NSDN/NGP/emulator/README.txt

看样子你需要去单独下载SDL2的lib，并放置到SDL2\lib\[x64/x86]下面
地址->https://www.libsdl.org/release/SDL2-devel-2.0.5-VC.zip
下载后解压并将SDL2-2.0.5文件夹内所有文件复制到项目文件夹下的SDL2里面，新版本的SDL2类推。
