NSDN/NGP/old-8bit/Cover.docx

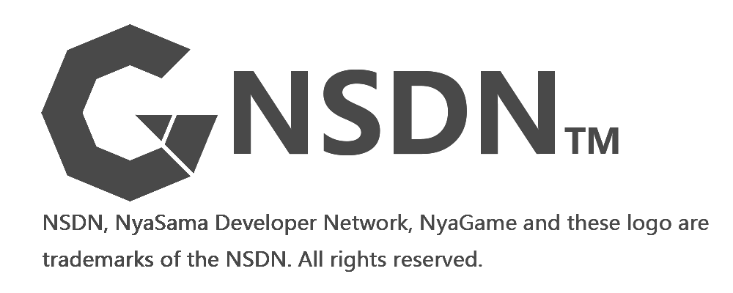
[picture p1: figure]
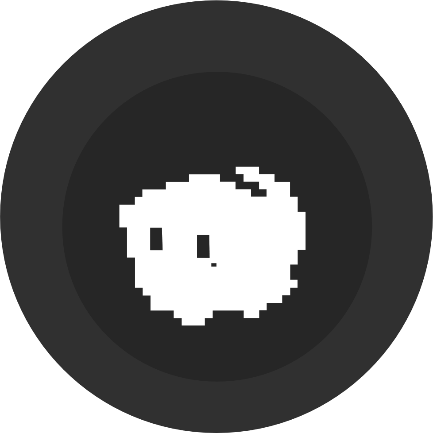
[picture p2: figure]

nyagame portable 8-bit

development doc
