NSDN/NGP/(list of files, drawings)

Other design files:
boards/ngp-main/logo.PcbLib
boards/ngp-main/ngp-main.PrjPCB
boards/ngp-main/ngp-main.SchDoc
boards/ngp-main/st-link.SchDoc
boards/st-link/st-link.PrjPCB
boards/st-link/st-link.SchDoc
layout/NyaGamePortable-32Bit-v1.0.lay6
layout/NyaGamePortable-32Bit-v1.1.lay6
layout/NyaGamePortable-32Bit-v1.2.lay6
old-8bit/Layout/NyaGamePortable-8Bit-v1.1.lay6
old-8bit/Layout/NyaGamePortable-8Bit-v1.2.lay6
old-8bit/Layout/NyaGamePortable-8Bit-v1.05.lay6
old-8bit/Layout/NyaGamePortable-8Bit.lay6
