NSDN/NGP/firmware/ngp-core/Src/main.c

/**
  ******************************************************************************
  * @file           : main.c
  * @brief          : Main program body
  ******************************************************************************
  * This notice applies to any and all portions of this file
  * that are not between comment pairs USER CODE BEGIN and
  * USER CODE END. Other portions of this file, whether 
  * inserted by the user or by software development tools
  * are owned by their respective copyright owners.
  *
  * Copyright (c) 2018 STMicroelectronics International N.V. 
  * All rights reserved.
  *
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
  ******************************************************************************
  */
/* Includes ------------------------------------------------------------------*/
#include "main.h"
#include "stm32f4xx_hal.h"
#include "fatfs.h"
#include "usb_device.h"

/* USER CODE BEGIN Includes */
#include "usbd_core.h"

#include "irq.h"
#include "lcd.h"
#include "rgboled.h"
#include "keypad.h"
#include "beeper.h"
#include "flash.h"

#define VERSION "dev180521"
/* USER CODE END Includes */

SD_HandleTypeDef hsd;

SPI_HandleTypeDef hspi1;

TIM_HandleTypeDef htim10;

UART_HandleTypeDef huart1;
UART_HandleTypeDef huart2;

/* USER CODE BEGIN PV */
	LCD* dev;
	Flash* flash;
	static uint8_t sdOK = 0;
	static uint8_t menu = 0;
	static uint8_t music = 0;
	
	const uint8_t cmusic = 7;
	
	HAL_SD_CardInfoTypeDef SDCardInfo;

	FATFS fileSystem;
	FIL testFile;
	uint8_t testBuffer[16] = "Hello Gensokyo!\0";
	UINT testBytes;
	FRESULT res;
/* USER CODE END PV */

void SystemClock_Config(void);
static void MX_GPIO_Init(void);
static void MX_SDIO_SD_Init(void);
static void MX_SPI1_Init(void);
static void MX_TIM10_Init(void);
static void MX_USART1_UART_Init(void);
static void MX_USART2_UART_Init(void);

/* USER CODE BEGIN PFP */

/** STG Begin *********************************************************************/

#define STG_BACK 1
#define STG_MAIN 2
#define STG_COLORB 0x000000

#define RANGE_X1 4
#define RANGE_Y1 4
#define RANGE_X2 92
#define RANGE_Y2 123

void onInitPlayer(void);
void onUpdatePlayer(void);
struct Player {
	uint32_t color;
	uint8_t size;
	double x;
	double y;
	double prevX;
	double prevY; 
	void (*onInit)();
	void (*onUpdate)();
} player = { 0xFF9800, 1,
	(RANGE_X2 + RANGE_X1) / 2, 108,
	(RANGE_X2 + RANGE_X1) / 2, 108,
	&onInitPlayer,
	&onUpdatePlayer
};
void onInitPlayer() {
	player.x = (RANGE_X2 + RANGE_X1) / 2;
	player.y = 108;
}
void onUpdatePlayer() {
	player.prevX = player.x; player.prevY = player.y;
	if (checkKey(LPAD_LEFT)) { player.x -= 0.4; }
	if (checkKey(LPAD_RIGHT)) { player.x += 0.4; }
	if (checkKey(LPAD_UP)) { player.y -= 0.4; }
	if (checkKey(LPAD_DOWN)) { player.y += 0.4; }

	if (player.x > RANGE_X2 - player.size) player.x = RANGE_X2 - player.size;
	if (player.x < RANGE_X1 + player.size) player.x = RANGE_X1 + player.size;
	if (player.y > RANGE_Y2 - player.size) player.y = RANGE_Y2 - player.size;
	if (player.y < RANGE_Y1 + player.size) player.y = RANGE_Y1 + player.size;

	if ((char) player.x != (char) player.prevX || (char) player.y != (char) player.prevY) {
		dev->colorf(dev->p, STG_COLORB);
		dev->rect(dev->p,
			player.prevX - player.size, player.prevY - player.size,
			player.prevX + player.size, player.prevY + player.size,
			1
		);
	}
	dev->colorf(dev->p, player.color);
	dev->rect(dev->p,
		player.x - player.size, player.y - player.size,
		player.x + player.size, player.y + player.size,
		1
	);
}

void STG(uint8_t type) {
	if (type == STG_BACK) {
		dev->colorf(dev->p, 0xFFFFFF);
		dev->rect(dev->p, RANGE_X1 - 4, RANGE_Y1 - 4, RANGE_X2 + 4, RANGE_Y2 + 4, 1);
		dev->colorf(dev->p, STG_COLORB);
		dev->rect(dev->p, RANGE_X1 - 2, RANGE_Y1 - 2, RANGE_X2 + 2, RANGE_Y2 + 2, 1);
		dev->colorf(dev->p, 0xFFFFFF);
		dev->rect(dev->p, RANGE_X1 - 1, RANGE_Y1 - 1, RANGE_X2 + 1, RANGE_Y2 + 1, 0);
		dev->colorf(dev->p, 0x7986CB);
		dev->font(dev->p, Big);
		dev->draw(dev->p, RANGE_X2 + 12, RANGE_Y1 + 4, 'T');
		dev->draw(dev->p, RANGE_X2 + 12 + 8, RANGE_Y1 + 4, 'H');
		dev->font(dev->p, Small);
		dev->colorf(dev->p, 0xFFFFFF);
		
		player.onInit();
	} else if (type == STG_MAIN) {
		player.onUpdate();
	}
}

/** STG End ***********************************************************************/

/* USER CODE END PFP */

/* USER CODE BEGIN 0 */
void checkSD() {
	if (HAL_GPIO_ReadPin(SDST_GPIO_Port, SDST_Pin) == GPIO_PIN_RESET && sdOK == 0) {
		HAL_SD_Init(&hsd);
		HAL_SD_GetCardInfo(&hsd, &SDCardInfo);
		sdOK = 1;
		USBD_Start(&hUsbDeviceFS);
	} else if (HAL_GPIO_ReadPin(SDST_GPIO_Port, SDST_Pin) == GPIO_PIN_SET && sdOK == 1) {
		HAL_SD_DeInit(&hsd);
		sdOK = 0;
		USBD_Stop(&hUsbDeviceFS);
	}
	if (sdOK == 1) {
		dev->colorb(dev->p, 0x66CCFF);
		dev->colorf(dev->p, 0x000000);
		dev->print(dev->p, 113, 118, "SD");
		dev->colorf(dev->p, 0x66CCFF);
		dev->rect(dev->p, 113, 117, 125, 125, 0);
		dev->colorb(dev->p, 0x000000);
		dev->colorf(dev->p, 0xFFFFFF);
	} else {
		dev->p->foreColor = dev->p->backColor;
		dev->rect(dev->p, 113, 117, 125, 125, 1);
		dev->colorf(dev->p, 0xFFFFFF);
	}
}

int halfWidth() { return dev->p->width / 2 - 1; }
int halfHeight() { return dev->p->height / 2 - 1; }
/* USER CODE END 0 */

/**
  * @brief  The application entry point.
  *
  * @retval None
  */
int main(void)
{
  /* MCU Configuration----------------------------------------------------------*/

  /* Reset of all peripherals, Initializes the Flash interface and the Systick. */
  HAL_Init();

  /* Configure the system clock */
  SystemClock_Config();

  /* Initialize all configured peripherals */
  MX_GPIO_Init();
  MX_SDIO_SD_Init();
  MX_SPI1_Init();
  MX_TIM10_Init();
  MX_USART1_UART_Init();
  MX_USART2_UART_Init();
  MX_FATFS_Init();
  MX_USB_DEVICE_Init();
  /* USER CODE BEGIN 2 */
	USBD_Stop(&hUsbDeviceFS);
	if (HAL_GPIO_ReadPin(SDST_GPIO_Port, SDST_Pin) == GPIO_PIN_RESET && sdOK == 0) {
		HAL_SD_Init(&hsd);
		HAL_SD_GetCardInfo(&hsd, &SDCardInfo);
		sdOK = 1;
		USBD_Start(&hUsbDeviceFS);
	} else if (HAL_GPIO_ReadPin(SDST_GPIO_Port, SDST_Pin) == GPIO_PIN_SET && sdOK == 1) {
		HAL_SD_DeInit(&hsd);
		sdOK = 0;
		USBD_Stop(&hUsbDeviceFS);
	}
  
	HAL_Delay(500);
	
	const uint8_t* logo = getLogo();
	const uint16_t* symbol = getSymbol();

	flash = FlashInit(&hspi1,
			FLASH_CS_GPIO_Port, FLASH_CS_Pin, W25Q64);
	
	dev = LCDInit(&hspi1, 0,
			LCD_DC_GPIO_Port, LCD_DC_Pin, 
			LCD_CS_GPIO_Port, LCD_CS_Pin,
			LCD_RST_GPIO_Port, LCD_RST_Pin,
			LCD_BK_GPIO_Port, LCD_BK_Pin);

	/*dev = LCDInit(&hspi1, 1,
			LCD_DC_GPIO_Port, LCD_DC_Pin,
			LCD_BK_GPIO_Port, LCD_BK_Pin,
			LCD_RST_GPIO_Port, LCD_RST_Pin,
			LCD_CS_GPIO_Port, LCD_CS_Pin);*/

	/*dev = RGBOLEDInit(&hspi1,
			LCD_DC_GPIO_Port, LCD_DC_Pin,
			LCD_CS_GPIO_Port, LCD_CS_Pin,
			LCD_RST_GPIO_Port, LCD_RST_Pin);*/

	dev->reset(dev->p);
	
	dev->init(dev->p);

	dev->colorb(dev->p, 0xFFFFFF);
	dev->colorf(dev->p, 0x000000);
	dev->clear(dev->p);
	dev->bitmapsc(dev->p, halfWidth() - 1, halfHeight() - 1, 64, 64, logo);
	HAL_Delay(2000);
	dev->colorb(dev->p, 0x000000);
	dev->colorf(dev->p, 0xFFFFFF);
	dev->clear(dev->p);
	
	HAL_GPIO_WritePin(LEDA_GPIO_Port, LEDA_Pin, GPIO_PIN_RESET);
	HAL_GPIO_WritePin(LEDB_GPIO_Port, LEDB_Pin, GPIO_PIN_SET);
	
	{
		
		f_mount(&fileSystem, SDPath, 1);
		if(f_mount(&fileSystem, SDPath, 1) == FR_OK) {
			uint8_t path[13] = "NYA_GAME.TXT";
			path[12] = '\0';
		 
			res = f_open(&testFile, (char*)path, FA_WRITE | FA_CREATE_ALWAYS);
		 
			res = f_write(&testFile, testBuffer, 16, &testBytes);
		 
			res = f_close(&testFile);
		}
	
	}

  /* USER CODE END 2 */

  /* Infinite loop */
  /* USER CODE BEGIN WHILE */
  while (1)
  {
	  if (menu < 10) {
			/* MENU BUILD BEGIN */
			dev->colorb(dev->p, 0x000000);
			dev->colorf(dev->p, 0xFF9800);
			dev->printfc(dev->p, 8, "MENU");
			dev->colorb(dev->p, 0x000000);
			dev->colorf(dev->p, 0xFFFFFF);
			dev->printfc(dev->p, 24, "W25Q64 Test");
			dev->printfc(dev->p, 32, "STG Sample");
			dev->printfc(dev->p, 40, "Flash Test");
			dev->printfc(dev->p, 48, "NSDN-Beeper");
			dev->printfc(dev->p, 56, "About this NGP");
			
			dev->draw(dev->p, (halfWidth() - 64) + 10, (menu + 2) * 8, ' ');
			dev->draw(dev->p, (halfWidth() - 64) + 10, (menu + 3) * 8, '>');
			dev->draw(dev->p, (halfWidth() - 64) + 10, (menu + 4) * 8, ' ');
			dev->draw(dev->p, (halfWidth() - 64) + 112, (menu + 2) * 8, ' ');
			dev->draw(dev->p, (halfWidth() - 64) + 112, (menu + 3) * 8, '<');
			dev->draw(dev->p, (halfWidth() - 64) + 112, (menu + 4) * 8, ' ');
			
			if (waitKeyUp(LPAD_UP)) menu = ((menu > 0) ? menu - 1 : 0);
			if (waitKeyUp(LPAD_DOWN)) menu = ((menu < 4) ? menu + 1 : 4);
			if (waitKeyUp(RPAD_UP)) {
				menu += 10;
				dev->clear(dev->p);
				
				switch (menu) {
				 	case 10:
						break;
					case 11:
						STG(STG_BACK);
						break;
					case 12:
						break;
					case 13:
						HAL_TIM_Base_Start_IT(&htim10);
						setVolume(5);
						music = 0;
						break;
					case 14:
						dev->colorb(dev->p, 0xFFFFFF);
						dev->colorf(dev->p, 0x000000);
						dev->clear(dev->p);
						break;
					default:
						break;
				}
			}
		} else if (menu < 20) {
			switch (menu) {
				case 10:
					dev->colorb(dev->p, 0x000000);
					dev->colorf(dev->p, 0xFF9800);
					dev->printfc(dev->p, 8, "W25Q64 Test");
					dev->colorb(dev->p, 0x000000);
					dev->colorf(dev->p, 0xFFFFFF);
					dev->printfc(dev->p, 48, "Init W25Q64...");
					uint8_t result = 0, manuf = 0, buf = 0;
					result = flash->begin(flash->p);
					manuf = flash->readManufacturer(flash->p);
					flash->read(flash->p, 0x00000000, &buf, 1);
					flash->end(flash->p);
					dev->printfc(dev->p, 64, "Result: %X", result);
					dev->printfc(dev->p, 72, "Manuf: %X", manuf);
					dev->printfc(dev->p, 80, "Buf: %X", buf);
					break;
				case 11:
					STG(STG_MAIN);
					break;
				case 12:
					dev->colorb(dev->p, 0x000000);
					dev->colorf(dev->p, 0xFF9800);
					dev->printfc(dev->p, 8, "Flash Test");
					dev->colorb(dev->p, 0x000000);
					dev->colorf(dev->p, 0x3F51B5);
					dev->printfc(dev->p, 24, "Flashing: 0x3F51B5");
					dev->rect(dev->p, 16, 48, dev->p->width - 16, dev->p->height - 16, 1);
					dev->colorf(dev->p, 0xB10000);
					dev->printfc(dev->p, 24, "Flashing: 0xB10000");
					dev->rect(dev->p, 16, 48, 112, 112, 1);
					dev->colorf(dev->p, 0xFFFFFF);
					break;
				case 13:
					dev->colorb(dev->p, 0x000000);
					dev->colorf(dev->p, 0xFF9800);
					dev->printfc(dev->p, 8, "NSDN-Beeper");
					dev->colorb(dev->p, 0x000000);
					dev->colorf(dev->p, 0xFFFFFF);
					dev->printfc(dev->p, 32, "NOW Playing...");
					dev->printfc(dev->p, 48, "%d of %d", cmusic, music + 1);
					switch (music) {
						case 0:
							dev->printfc(dev->p, 64, "Septet for");
							dev->printfc(dev->p, 72, "the Dead Princess");
							playMusicWithSpace(symbol, getMusic(0), 233, 16, 1);
							break;
						case 1:
							dev->printfc(dev->p, 64, "The Way of Doom God");
							dev->printfc(dev->p, 72, "- Dark Road -");
							playMusicWithSpace(symbol, getMusic(1), 233, 16, 1);
							break;
						case 2:
							dev->printfc(dev->p, 64, "Romantic Escape");
							dev->printfc(dev->p, 72, "Flight & Foul for");
							dev->printfc(dev->p, 80, "Impossible Bullets"); 
							playMusicWithSpace(symbol, getMusic(2), 233, 16, 1);
							break;
						case 3:
							dev->printfc(dev->p, 64, "Lively and Innocent");
							dev->printfc(dev->p, 72, "Girl (9)");
							playMusicWithSpace(symbol, getMusic(3), 233, 16, 1);
							break;
						case 4:
							dev->printfc(dev->p, 64, "Broken Moon");
							playMusicWithSpace(symbol, getMusic(4), 233, 16, 1);
							break;
						case 5:
							dev->printfc(dev->p, 64, "U.N. Owen was her?");
							playMusicWithSpace(symbol, getMusic(5), 128, 16, 1);
							break;
						case 6:
							dev->printfc(dev->p, 64, "Staking Your Life");
							dev->printfc(dev->p, 72, "on a Prank");
							playMusicWithSpace(symbol, getMusic(6), 192, 8, 1);
							break;
					}
					break;
				case 14:
					dev->colorb(dev->p, 0xFFFFFF);
					dev->colorf(dev->p, 0x000000);
					dev->bitmapsc(dev->p, halfWidth() - 1, (halfHeight() - 64) + 48, 64, 64, logo);
					dev->printfc(dev->p, (halfHeight() - 64) + 86, "NyaGame Portable");
					dev->printfc(dev->p, (halfHeight() - 64) + 98, VERSION);
					break;
				default:
					break;
			}
			
			if (menu == 11) {
				if (waitKeyUp(RPAD_DOWN)) {
					menu -= 10;
					dev->colorb(dev->p, 0x000000);
					dev->colorf(dev->p, 0xFF9800);
					dev->clear(dev->p);
				}
			}
			if (menu != 13 && menu != 11) {
				if (waitKeyUp(RPAD_RIGHT)) {
					menu -= 10;
					dev->colorb(dev->p, 0x000000);
					dev->colorf(dev->p, 0xFF9800);
					dev->clear(dev->p);
					
					switch (menu) {
						case 10:
							break;
						case 11:
							break;
						case 12:
							break;
						case 13:
							HAL_TIM_Base_Start_IT(&htim10);
							setVolume(2);
							break;
						case 14:
							break;
						default:
							break;
					}
				}
			}
		} else {
			menu = 0;
			dev->clear(dev->p);
		}
  /* USER CODE END WHILE */

  /* USER CODE BEGIN 3 */
		HAL_GPIO_TogglePin(LEDA_GPIO_Port, LEDA_Pin);
		HAL_GPIO_TogglePin(LEDB_GPIO_Port, LEDB_Pin);
		checkSD();
  }
  /* USER CODE END 3 */

}

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
/* USER CODE BEGIN 4 */

void TIM_IRQ_Callback(TIM_HandleTypeDef *htim)
{
	if (htim->Instance == TIM10) {
		if (menu == 13) {
			if (waitKeyUp(RPAD_RIGHT)) {
				jumpOut();
				menu -= 10;
				dev->colorb(dev->p, 0x000000);
				dev->clear(dev->p);
				HAL_TIM_Base_Stop_IT(&htim10);
				HAL_GPIO_WritePin(LBEEP_GPIO_Port, LBEEP_Pin, GPIO_PIN_RESET);
				HAL_GPIO_WritePin(RBEEP_GPIO_Port, RBEEP_Pin, GPIO_PIN_RESET);
			}
			if (waitKeyUp(LPAD_UP)) {
				if (music > 0) music -= 1;
				else music = cmusic - 1;
				jumpOut();
				dev->colorb(dev->p, 0x000000);
				dev->clear(dev->p);
			} else if (waitKeyUp(LPAD_DOWN)) {
				if (music < cmusic - 1) music += 1;
				else music = 0;
				jumpOut();
				dev->colorb(dev->p, 0x000000);
				dev->clear(dev->p);
			}
		}
		beeperInerrupt();
	}

	
}

/* USER CODE END 4 */
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
