NSDN/NGP/firmware/ngp-main/ngp-main.ioc

Mcu.UserName=STM32F405RGTx
PA0-WKUP.GPIO_Label=BAT_ADC
PA0-WKUP.Signal=ADCx_IN0
PA1.GPIO_Label=BAT_CHG
PA1.Signal=GPIO_Input
PA10.Signal=USART1_RX
PA11.Signal=USB_OTG_FS_DM
PA12.Signal=USB_OTG_FS_DP
PA13.Signal=SYS_JTMS-SWDIO
PA14.Signal=SYS_JTCK-SWCLK
PA15.GPIO_Label=SYS_LED
PA15.Signal=GPIO_Output
PA2.GPIO_Label=BAT_STD
PA2.Signal=GPIO_Input
PA3.GPIO_Label=BAT_CE
PA3.Signal=GPIO_Output
PA4.GPIO_Label=LCD_CS
PA4.Signal=GPIO_Output
PA5.Signal=SPI1_SCK
PA6.Signal=SPI1_MISO
PA7.Signal=SPI1_MOSI
PA8.GPIO_Label=SDIO_CHK
PA8.Signal=GPIO_Input
PA9.Signal=USART1_TX
PB0.GPIO_Label=KEY_INA
PB0.Signal=GPIO_Input
PB1.GPIO_Label=KEY_INB
PB1.Signal=GPIO_Input
PB10.Signal=SPI2_SCK
PB11.GPIO_Label=FLASH_CS
PB11.Signal=GPIO_Output
PB12.Signal=USB_OTG_HS_ID
PB13.GPIO_Label=BLE_STE
PB13.Signal=GPIO_Input
PB14.Signal=USB_OTG_HS_DM
PB15.Signal=USB_OTG_HS_DP
PB2.GPIO_Label=KEY_INC
PB2.Signal=GPIO_Input
PB3.GPIO_Label=KEY_IND
PB3.Signal=GPIO_Input
PB4.GPIO_Label=LED_A
PB4.Signal=GPIO_Output
PB5.GPIO_Label=LED_B
PB5.Signal=GPIO_Output
PB6.Signal=I2C1_SCL
PB7.Signal=I2C1_SDA
PB8.GPIO_Label=BEEP_L
PB8.Signal=GPIO_Output
PB9.GPIO_Label=BEEP_R
PB9.Signal=GPIO_Output
PC0.GPIO_Label=KEY_OUTA
PC0.Signal=GPIO_Output
PC1.GPIO_Label=KEY_OUTB
PC1.Signal=GPIO_Output
PC10.Signal=SDIO_D2
PC11.Signal=SDIO_D3
PC12.Signal=SDIO_CK
PC13-ANTI_TAMP.GPIO_Label=LCD_BL
PC13-ANTI_TAMP.Signal=GPIO_Output
PC14-OSC32_IN.Signal=RCC_OSC32_IN
PC15-OSC32_OUT.Signal=RCC_OSC32_OUT
PC2.Signal=SPI2_MISO
PC3.Signal=SPI2_MOSI
PC4.GPIO_Label=LCD_DC
PC4.Signal=GPIO_Output
PC5.GPIO_Label=LCD_RST
PC5.Signal=GPIO_Output
PC6.Signal=USART6_TX
PC7.Signal=USART6_RX
PC8.Signal=SDIO_D0
PC9.Signal=SDIO_D1
PD2.Signal=SDIO_CMD
PH0-OSC_IN.Signal=RCC_OSC_IN
PH1-OSC_OUT.Signal=RCC_OSC_OUT
