NSDN/NGP/firmware/ngp-main/Drivers/NGP/nsio.c

#include "./Include/nsio.h"

#include <stdio.h>
#include <string.h>
#include <stdarg.h>
#include <malloc.h>

#include "./Include/lcd.h"
#include "./Include/rgboled.h"
extern SCREENTYPE* SCREEN;

#include "fatfs.h"
extern uint8_t FS_OK;

char* strlwr(char* s) {
	char* str;
	str = s;
	while(*str != '\0') {
		if(*str >= 'A' && *str <= 'Z') {
			*str += 'a'-'A';
		}
		str++;
	}
	return s;
}

#define __print(buf) SCREEN->printfa(SCREEN->p, buf)
int print(const char* format, ...) {
	char* iobuf = malloc(sizeof(char) * IOBUF);
	va_list args;
	va_start(args, format);
	int result = vsprintf(iobuf, format, args);
	va_end(args);
	__print(iobuf);
	free(iobuf);
	return result;
}
int scan(char* buffer) {
	unsigned char count = 0, tmp = '\0';
	while (1) {
		if (HAL_UART_Receive(&HUART, &tmp, 1, 1) == HAL_OK) {
			if (tmp == '\n') {
				SCREEN->draw(SCREEN->p, SCREEN->p->ptrX, SCREEN->p->ptrY, ' ');
				break;
			}
			buffer[count] = tmp;
			if (buffer[count] == 0x08 && count > 0) {
				count -= 1;
				print("%c", 0x08);
				continue;
			} else if (buffer[count] != 0x08) {
				print("%c", buffer[count]);
				count += 1;
			}
		}
		SCREEN->draw(SCREEN->p, SCREEN->p->ptrX, SCREEN->p->ptrY, '_');
		SCREEN->draw(SCREEN->p, SCREEN->p->ptrX + (SCREEN->p->Font == Big ? 8 : 6), SCREEN->p->ptrY, ' ');
	}
	buffer[count] = '\0';
	print("\n");
	return count;
}
int fscan(char* buffer, const char* format, ...) {
	scan(buffer);
	va_list args;
	va_start(args, format);
	int result = vsscanf(buffer, format, args);
	va_end(args);
	return result;
}

char* read(char* path) {
	if (FS_OK == 0) {
		print("File system error.\n");
		return OK;
	}
	FRESULT res; FIL f;
	res = f_open(&f, path, FA_READ);
	if (res != FR_OK) {
		print("File open failed.\n");
		print("At file: %s\n\n", path);
		return OK;
	}
	int length = 0; char tmp[2];
	while (f_eof(&f) == 0) {
		f_gets(tmp, 2, &f);
		if (tmp[0] != '\r')
			length += 1;
	}
	f_close(&f);
	res = f_open(&f, path, FA_READ);
	if (res != FR_OK) {
		print("File open failed.\n");
		print("At file: %s\n\n", path);
		return OK;
	}
	char* data = malloc(sizeof(char) * (length + 1));
	length = 0;
	while (f_eof(&f) == 0) {
		f_gets(tmp, 2, &f);
		if (tmp[0] != '\r') {
			data[length] = tmp[0];
			length += 1;
		}
	}
	f_close(&f);
	data[length] = '\0';
	return data;
}

int lines(char* src) {
	if(src == 0) return OK;
	int cnt = 0, length = strlen(src);
	for (int i = 0; i < length; i++)
		if (src[i] == '\n') cnt += 1;
	return cnt;
}

char* line(char* src, int index) {
	if (index >= lines(src)) return OK;
	int srcLen = strlen(src), cnt = 0, pos = 0;
	char* buf = malloc(sizeof(char) * srcLen);
	char* result = 0;
	for (int i = 0; i < srcLen; i++) {
		if (index == 0) {
			for (i = 0; src[i] != '\n'; i++)
				buf[i] = src[i];
			pos = i + 1;
			result = malloc(sizeof(char) * (pos));
			for (i = 0; i < pos; i++) {
				if (i == pos - 1) {
					result[i] = '\0';
					break;
				}
				result[i] = buf[i];
			}
			free(buf);
			return result;
		}
		if (index == cnt) {
			pos = i;
			for (; src[i] != '\n'; i++)
				buf[i - pos] = src[i];
			pos = i - pos + 1;
			result = malloc(sizeof(char) * pos);
			for (i = 0; i < pos; i++) {
				if (i == pos - 1) {
					result[i] = '\0';
					break;
				}
				result[i] = buf[i];
			}
			free(buf);
			return result;
		}
		if (src[i] == '\n') cnt += 1;
	}
	return OK;
}

char* get(char* src, int start, char* buf, int size) {
	for (int i = 0; i < size; i++) {
		if (i == size - 1) {
			buf[i] = '\0';
			break;
		}
		buf[i] = src[start + i];
	}
	return buf;
}

char* cut(char* src, const char* head) {
	int srcLen = strlen(src), headLen = strlen(head) + 1;
	char* headBuf = malloc(sizeof(char) * headLen);
	char* bodyBuf = malloc(sizeof(char) * srcLen);
	int start = 0, size, cnt; char* buf = 0; char* blk = 0;
	for (int i = 0; i < srcLen - headLen; i++) {
		if (strcmp(get(src, i, headBuf, headLen), head) == 0) {
			for (; i < srcLen; i++) {
				if (src[i] == '{') {
					start = i += 1;
					for (; i < srcLen; i++) {
						if (src[i] == '}') break;
						if (i == srcLen) return OK;
						bodyBuf[i - start] = src[i];
					}
					break;
				}
			}
			size = i - start + 1;
			buf = malloc(sizeof(char) * size);
			for (cnt = i = 0; i < size; i++) {
				if (i == size - 1) {
					buf[i] = '\0';
					break;
				}
				if (i == 0 && bodyBuf[i] == '\n') {
					cnt += 1;
					continue;
				}
				if (bodyBuf[i] == ' ' && bodyBuf[i - 1] == ' ') {
					cnt += 1;
					continue;
				}
				if (bodyBuf[i] == '\n' && bodyBuf[i - 1] == '\n') {
					cnt += 1;
					continue;
				}
				if (bodyBuf[i] == '\n' && bodyBuf[i - 1] == '\t') {
					cnt += 1;
					continue;
				}
				if (bodyBuf[i] == '\t' && bodyBuf[i - 1] == '\t') {
					cnt += 1;
					continue;
				}
				if (bodyBuf[i] == '\t' && bodyBuf[i - 1] == '\n') {
					cnt += 1;
					continue;
				}
				buf[i - cnt] = bodyBuf[i];
			}
			size -= cnt;
			blk = malloc(sizeof(char) * size);
			for (i = 0; i < size; i++) {
				if (i == size - 1) {
					blk[i] = '\0';
					break;
				}
				blk[i] = buf[i];
			}
			free(buf);
			free(bodyBuf);
			free(headBuf);
			return blk;
		}
	}
	return OK;
}
