NSDN/NGP/Firmware/NGPTest/Src/main.c

/**
  ******************************************************************************
  * File Name          : main.c
  * Description        : Main program body
  ******************************************************************************
  *
  * Copyright (c) 2016 STMicroelectronics International N.V. 
  * All rights reserved.
  *
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
  ******************************************************************************
  */
/* Includes ------------------------------------------------------------------*/
#include "main.h"
#include "stm32f1xx_hal.h"
#include "fatfs.h"
#include "usb_device.h"

/* USER CODE BEGIN Includes */
#include "OLED.h"
#include "LCD.h"
#include "Keypad.h"
#include "Beeper.h"
#include "Flash.h"
/* USER CODE END Includes */

SD_HandleTypeDef hsd;
HAL_SD_CardInfoTypedef SDCardInfo;

SPI_HandleTypeDef hspi1;
DMA_HandleTypeDef hdma_spi1_tx;
DMA_HandleTypeDef hdma_spi1_rx;

TIM_HandleTypeDef htim6;
TIM_HandleTypeDef htim7;

UART_HandleTypeDef huart1;
UART_HandleTypeDef huart2;

/* USER CODE BEGIN PV */
	LCD* lcd;
	Flash* flash;
	static uint8_t sdOK = 0;
	static uint8_t index = 0;
/* USER CODE END PV */

void SystemClock_Config(void);
void Error_Handler(void);
static void MX_GPIO_Init(void);
static void MX_DMA_Init(void);
static void MX_SDIO_SD_Init(void);
static void MX_USART2_UART_Init(void);
static void MX_SPI1_Init(void);
static void MX_USART1_UART_Init(void);
static void MX_TIM6_Init(void);
static void MX_TIM7_Init(void);

/* USER CODE BEGIN PFP */

/** STG Begin *********************************************************************/

#define STG_BACK 1
#define STG_MAIN 2
#define STG_COLORB 0x000000

#define RANGE_X1 4
#define RANGE_Y1 4
#define RANGE_X2 92
#define RANGE_Y2 123

void onInitPlayer(void);
void onUpdatePlayer(void);
struct Player {
	uint32_t color;
	uint8_t size;
	float x;
	float y;
	float prevX;
	float prevY;
	void (*onInit)();
	void (*onUpdate)();
} player = { 0xFF9800, 1,
	(RANGE_X2 + RANGE_X1) / 2, 108,
	(RANGE_X2 + RANGE_X1) / 2, 108,
	&onInitPlayer,
	&onUpdatePlayer
};
void onInitPlayer() {
	player.x = (RANGE_X2 + RANGE_X1) / 2;
	player.y = 108;
}
void onUpdatePlayer() {
	player.prevX = player.x; player.prevY = player.y;
	if (checkKey(LPAD_LEFT)) { player.x -= 0.4; }
	if (checkKey(LPAD_RIGHT)) { player.x += 0.4; }
	if (checkKey(LPAD_UP)) { player.y -= 0.4; }
	if (checkKey(LPAD_DOWN)) { player.y += 0.4; }

	if (player.x > RANGE_X2 - player.size) player.x = RANGE_X2 - player.size;
	if (player.x < RANGE_X1 + player.size) player.x = RANGE_X1 + player.size;
	if (player.y > RANGE_Y2 - player.size) player.y = RANGE_Y2 - player.size;
	if (player.y < RANGE_Y1 + player.size) player.y = RANGE_Y1 + player.size;

	if ((char) player.x != (char) player.prevX || (char) player.y != (char) player.prevY) {
		lcd->colorf(lcd->p, STG_COLORB);
		lcd->rect(lcd->p,
			player.prevX - player.size, player.prevY - player.size,
			player.prevX + player.size, player.prevY + player.size,
			1
		);
	}
	lcd->colorf(lcd->p, player.color);
	lcd->rect(lcd->p,
		player.x - player.size, player.y - player.size,
		player.x + player.size, player.y + player.size,
		1
	);
}

void STG(uint8_t type) {
	if (type == STG_BACK) {
		lcd->colorf(lcd->p, 0xFFFFFF);
		lcd->rect(lcd->p, RANGE_X1 - 4, RANGE_Y1 - 4, RANGE_X2 + 4, RANGE_Y2 + 4, 1);
		lcd->colorf(lcd->p, STG_COLORB);
		lcd->rect(lcd->p, RANGE_X1 - 2, RANGE_Y1 - 2, RANGE_X2 + 2, RANGE_Y2 + 2, 1);
		lcd->colorf(lcd->p, 0xFFFFFF);
		lcd->rect(lcd->p, RANGE_X1 - 1, RANGE_Y1 - 1, RANGE_X2 + 1, RANGE_Y2 + 1, 0);
		lcd->colorf(lcd->p, 0x7986CB);
		lcd->font(lcd->p, Big);
		lcd->draw(lcd->p, RANGE_X2 + 12, RANGE_Y1 + 4, 'T');
		lcd->draw(lcd->p, RANGE_X2 + 12 + 8, RANGE_Y1 + 4, 'H');
		lcd->font(lcd->p, Small);
		lcd->colorf(lcd->p, 0xFFFFFF);
		
		player.onInit();
	} else if (type == STG_MAIN) {
		player.onUpdate();
	}
}

/** STG End ***********************************************************************/

/* USER CODE END PFP */

/* USER CODE BEGIN 0 */
void checkSD() {
	if (HAL_GPIO_ReadPin(SDST_GPIO_Port, SDST_Pin) == GPIO_PIN_RESET && sdOK == 0) {
		HAL_SD_Init(&hsd, &SDCardInfo);
		sdOK = 1;
	} else if (HAL_GPIO_ReadPin(SDST_GPIO_Port, SDST_Pin) == GPIO_PIN_SET && sdOK == 1) {
		HAL_SD_DeInit(&hsd);
		sdOK = 0;	
	}
	if (sdOK == 1) {
		lcd->colorb(lcd->p, 0x66CCFF);
		lcd->colorf(lcd->p, 0x000000);
		lcd->print(lcd->p, 113, 118, "SD");
		lcd->colorf(lcd->p, 0x66CCFF);
		lcd->rect(lcd->p, 113, 117, 125, 125, 0);
		lcd->colorb(lcd->p, 0x000000);
		lcd->colorf(lcd->p, 0xFFFFFF);
	} else {
		lcd->colorf(lcd->p, 0x000000);
		lcd->rect(lcd->p, 113, 117, 125, 125, 1);
		lcd->colorf(lcd->p, 0xFFFFFF);
	}
}
/* USER CODE END 0 */

int main(void)
{

  /* MCU Configuration----------------------------------------------------------*/

  /* Reset of all peripherals, Initializes the Flash interface and the Systick. */
  HAL_Init();

  /* Configure the system clock */
  SystemClock_Config();
  HAL_Delay(100);
  /* Initialize all configured peripherals */
  MX_GPIO_Init();
  MX_DMA_Init();
  MX_USB_DEVICE_Init();
  MX_SDIO_SD_Init();
  MX_USART2_UART_Init();
  MX_FATFS_Init();
  MX_SPI1_Init();
  MX_USART1_UART_Init();
  MX_TIM6_Init();
  MX_TIM7_Init();

  /* USER CODE BEGIN 2 */
	if (HAL_GPIO_ReadPin(SDST_GPIO_Port, SDST_Pin) == GPIO_PIN_RESET && sdOK == 0) {
		HAL_SD_Init(&hsd, &SDCardInfo);
		sdOK = 1;
	} else if (HAL_GPIO_ReadPin(SDST_GPIO_Port, SDST_Pin) == GPIO_PIN_SET && sdOK == 1) {
		HAL_SD_DeInit(&hsd);
		sdOK = 0;	
	}
  
	HAL_Delay(500);
	
	flash = FlashInit(&hspi1,
			FLASH_CS_GPIO_Port, FLASH_CS_Pin, W25Q64);
	
	lcd = LCDInit(&hspi1, 
			LCD_DC_GPIO_Port, LCD_DC_Pin, 
			LCD_CS_GPIO_Port, LCD_CS_Pin,
			LCD_RST_GPIO_Port, LCD_RST_Pin,
			LCD_BK_GPIO_Port, LCD_BK_Pin);
			
	lcd->reset(lcd->p);
	
	lcd->init(lcd->p);
	lcd->colorb(lcd->p, 0xFFFFFF);
	lcd->colorf(lcd->p, 0x000000);
	lcd->clear(lcd->p);
	lcd->bitmapsc(lcd->p, 63, 63, 64, 64, __NYAGAME_LOGO_);
	HAL_Delay(2000);
	lcd->colorb(lcd->p, 0x000000);
	lcd->colorf(lcd->p, 0xFFFFFF);
	lcd->clear(lcd->p);
	
	HAL_GPIO_WritePin(LEDA_GPIO_Port, LEDA_Pin, GPIO_PIN_RESET);
	HAL_GPIO_WritePin(LEDB_GPIO_Port, LEDB_Pin, GPIO_PIN_SET);
	
  /* USER CODE END 2 */

  /* Infinite loop */
  /* USER CODE BEGIN WHILE */
	while (1) {
		
		if (index < 10) {
			/* MENU BUILD BEGIN */
			lcd->colorb(lcd->p, 0x000000);
			lcd->colorf(lcd->p, 0xFF9800);
			lcd->printfc(lcd->p, 8, "MENU");
			lcd->colorb(lcd->p, 0x000000);
			lcd->colorf(lcd->p, 0xFFFFFF);
			lcd->printfc(lcd->p, 24, "W25Q64 Test");
			lcd->printfc(lcd->p, 32, "STG Sample");
			lcd->printfc(lcd->p, 40, "Flash Test");
			lcd->printfc(lcd->p, 48, "NSDN-Beeper");
			lcd->printfc(lcd->p, 56, "About this NGP");
			
			lcd->draw(lcd->p, 10, (index + 2) * 8, ' ');
			lcd->draw(lcd->p, 10, (index + 3) * 8, '>');
			lcd->draw(lcd->p, 10, (index + 4) * 8, ' ');
			lcd->draw(lcd->p, 112, (index + 2) * 8, ' ');
			lcd->draw(lcd->p, 112, (index + 3) * 8, '<');
			lcd->draw(lcd->p, 112, (index + 4) * 8, ' ');
			
			if (waitKeyUp(LPAD_UP)) index = ((index > 0) ? index - 1 : 0);
			if (waitKeyUp(LPAD_DOWN)) index = ((index < 4) ? index + 1 : 4);
			if (waitKeyUp(RPAD_UP)) {
				index += 10;
				lcd->clear(lcd->p);
				
				switch (index) {
					case 10:
						break;
					case 11:
						STG(STG_BACK);
						break;
					case 12:
						break;
					case 13:
						HAL_TIM_Base_Start_IT(&htim6);
						setVolume(2);
						break;
					case 14:
						lcd->colorb(lcd->p, 0xFFFFFF);
						lcd->colorf(lcd->p, 0x000000);
						lcd->clear(lcd->p);
						break;
					default:
						break;
				}
			}
		} else if (index < 20) {
			switch (index) {
				case 10:
					lcd->colorb(lcd->p, 0x000000);
					lcd->colorf(lcd->p, 0xFF9800);
					lcd->printfc(lcd->p, 8, "W25Q64 Test");
					lcd->colorb(lcd->p, 0x000000);
					lcd->colorf(lcd->p, 0xFFFFFF);
					lcd->printfc(lcd->p, 48, "Init W25Q64...");
					uint8_t result, manuf, buf;
					result = flash->begin(flash->p);
					manuf = flash->readManufacturer(flash->p);
					flash->read(flash->p, 0x00000000, &buf, 1);
					flash->end(flash->p);
					lcd->printfc(lcd->p, 64, "Result: %X", result);
					lcd->printfc(lcd->p, 72, "Manuf: %X", manuf);
					lcd->printfc(lcd->p, 80, "Buf: %X", buf);
					break;
				case 11:
					STG(STG_MAIN);
					break;
				case 12:
					lcd->colorb(lcd->p, 0x000000);
					lcd->colorf(lcd->p, 0xFF9800);
					lcd->printfc(lcd->p, 8, "Flash Test");
					lcd->colorb(lcd->p, 0x000000);
					lcd->colorf(lcd->p, 0x3F51B5);
					lcd->printfc(lcd->p, 24, "Flashing: 0x3F51B5");
					lcd->rect(lcd->p, 16, 48, 112, 112, 1);
					lcd->colorf(lcd->p, 0xB10000);
					lcd->printfc(lcd->p, 24, "Flashing: 0xB10000");
					lcd->rect(lcd->p, 16, 48, 112, 112, 1);
					lcd->colorf(lcd->p, 0xFFFFFF);
					break;
				case 13:
					lcd->colorb(lcd->p, 0x000000);
					lcd->colorf(lcd->p, 0xFF9800);
					lcd->printfc(lcd->p, 8, "NSDN-Beeper");
					lcd->colorb(lcd->p, 0x000000);
					lcd->colorf(lcd->p, 0xFFFFFF);
					lcd->printfc(lcd->p, 32, "NOW Playing...");
					lcd->printfc(lcd->p, 48, "Remilia");
					lcd->printfc(lcd->p, 56, "Scarlet");
					playMusicWithSpace(SYMBOL, MID_remilia, MID_remilia_LENGTH, 233, 16, 1);
					break;
				case 14:
					lcd->colorb(lcd->p, 0xFFFFFF);
					lcd->colorf(lcd->p, 0x000000);
					lcd->bitmapsc(lcd->p, 63, 48, 64, 64, __NYAGAME_LOGO_);
					lcd->printfc(lcd->p, 86, "NyaGame Portable");
					lcd->printfc(lcd->p, 98, "dev161218");
					lcd->colorb(lcd->p, 0x000000);
					lcd->colorf(lcd->p, 0xFFFFFF);
					break;
				default:
					break;
			}
			
			if (index == 11) {
				if (waitKeyUp(RPAD_DOWN)) {
					index -= 10;
					lcd->clear(lcd->p);
				}
			}
			if (index != 13 && index != 11) {
				if (waitKeyUp(RPAD_RIGHT)) {
					index -= 10;
					lcd->clear(lcd->p);
					
					switch (index) {
						case 10:
							break;
						case 11:
							break;
						case 12:
							break;
						case 13:
							HAL_TIM_Base_Start_IT(&htim6);
							setVolume(2);
							break;
						case 14:
							break;
						default:
							break;
					}
				}
			}
		} else {
			index = 0;
			lcd->clear(lcd->p);
		}
		/* MENU BUILD END */
		
  /* USER CODE END WHILE */

  /* USER CODE BEGIN 3 */
		HAL_GPIO_TogglePin(LEDA_GPIO_Port, LEDA_Pin);
		HAL_GPIO_TogglePin(LEDB_GPIO_Port, LEDB_Pin);
		checkSD();
	}
  /* USER CODE END 3 */

}

/** System Clock Configuration
*/
void SystemClock_Config(void)
{

  RCC_OscInitTypeDef RCC_OscInitStruct;
  RCC_ClkInitTypeDef RCC_ClkInitStruct;
  RCC_PeriphCLKInitTypeDef PeriphClkInit;

    /**Initializes the CPU, AHB and APB busses clocks 
    */
  RCC_OscInitStruct.OscillatorType = RCC_OSCILLATORTYPE_HSE;
  RCC_OscInitStruct.HSEState = RCC_HSE_ON;
  RCC_OscInitStruct.HSEPredivValue = RCC_HSE_PREDIV_DIV1;
  RCC_OscInitStruct.HSIState = RCC_HSI_ON;
  RCC_OscInitStruct.PLL.PLLState = RCC_PLL_ON;
  RCC_OscInitStruct.PLL.PLLSource = RCC_PLLSOURCE_HSE;
  RCC_OscInitStruct.PLL.PLLMUL = RCC_PLL_MUL9;
  if (HAL_RCC_OscConfig(&RCC_OscInitStruct) != HAL_OK)
  {
    Error_Handler();
  }

    /**Initializes the CPU, AHB and APB busses clocks 
    */
  RCC_ClkInitStruct.ClockType = RCC_CLOCKTYPE_HCLK|RCC_CLOCKTYPE_SYSCLK
                              |RCC_CLOCKTYPE_PCLK1|RCC_CLOCKTYPE_PCLK2;
  RCC_ClkInitStruct.SYSCLKSource = RCC_SYSCLKSOURCE_PLLCLK;
  RCC_ClkInitStruct.AHBCLKDivider = RCC_SYSCLK_DIV1;
  RCC_ClkInitStruct.APB1CLKDivider = RCC_HCLK_DIV2;
  RCC_ClkInitStruct.APB2CLKDivider = RCC_HCLK_DIV1;

  if (HAL_RCC_ClockConfig(&RCC_ClkInitStruct, FLASH_LATENCY_2) != HAL_OK)
  {
    Error_Handler();
  }

  PeriphClkInit.PeriphClockSelection = RCC_PERIPHCLK_USB;
  PeriphClkInit.UsbClockSelection = RCC_USBCLKSOURCE_PLL_DIV1_5;
  if (HAL_RCCEx_PeriphCLKConfig(&PeriphClkInit) != HAL_OK)
  {
    Error_Handler();
  }

    /**Enables the Clock Security System 
    */
  HAL_RCC_EnableCSS();

    /**Configure the Systick interrupt time 
    */
  HAL_SYSTICK_Config(HAL_RCC_GetHCLKFreq()/1000);

    /**Configure the Systick 
    */
  HAL_SYSTICK_CLKSourceConfig(SYSTICK_CLKSOURCE_HCLK);

  /* SysTick_IRQn interrupt configuration */
  HAL_NVIC_SetPriority(SysTick_IRQn, 0, 0);
}

/* SDIO init function */
static void MX_SDIO_SD_Init(void)
{

  hsd.Instance = SDIO;
  hsd.Init.ClockEdge = SDIO_CLOCK_EDGE_RISING;
  hsd.Init.ClockBypass = SDIO_CLOCK_BYPASS_DISABLE;
  hsd.Init.ClockPowerSave = SDIO_CLOCK_POWER_SAVE_DISABLE;
  hsd.Init.BusWide = SDIO_BUS_WIDE_1B;
  hsd.Init.HardwareFlowControl = SDIO_HARDWARE_FLOW_CONTROL_DISABLE;
  hsd.Init.ClockDiv = 3;

}

/* SPI1 init function */
static void MX_SPI1_Init(void)
{

  hspi1.Instance = SPI1;
  hspi1.Init.Mode = SPI_MODE_MASTER;
  hspi1.Init.Direction = SPI_DIRECTION_2LINES;
  hspi1.Init.DataSize = SPI_DATASIZE_8BIT;
  hspi1.Init.CLKPolarity = SPI_POLARITY_HIGH;
  hspi1.Init.CLKPhase = SPI_PHASE_1EDGE;
  hspi1.Init.NSS = SPI_NSS_SOFT;
  hspi1.Init.BaudRatePrescaler = SPI_BAUDRATEPRESCALER_4;
  hspi1.Init.FirstBit = SPI_FIRSTBIT_MSB;
  hspi1.Init.TIMode = SPI_TIMODE_DISABLE;
  hspi1.Init.CRCCalculation = SPI_CRCCALCULATION_DISABLE;
  hspi1.Init.CRCPolynomial = 10;
  if (HAL_SPI_Init(&hspi1) != HAL_OK)
  {
    Error_Handler();
  }

}

/* TIM6 init function */
static void MX_TIM6_Init(void)
{

  TIM_MasterConfigTypeDef sMasterConfig;

  htim6.Instance = TIM6;
  htim6.Init.Prescaler = 2;
  htim6.Init.CounterMode = TIM_COUNTERMODE_UP;
  htim6.Init.Period = 359;
  if (HAL_TIM_Base_Init(&htim6) != HAL_OK)
  {
    Error_Handler();
  }

  sMasterConfig.MasterOutputTrigger = TIM_TRGO_RESET;
  sMasterConfig.MasterSlaveMode = TIM_MASTERSLAVEMODE_DISABLE;
  if (HAL_TIMEx_MasterConfigSynchronization(&htim6, &sMasterConfig) != HAL_OK)
  {
    Error_Handler();
  }

}

/* TIM7 init function */
static void MX_TIM7_Init(void)
{

  TIM_MasterConfigTypeDef sMasterConfig;

  htim7.Instance = TIM7;
  htim7.Init.Prescaler = 2;
  htim7.Init.CounterMode = TIM_COUNTERMODE_UP;
  htim7.Init.Period = 35;
  if (HAL_TIM_Base_Init(&htim7) != HAL_OK)
  {
    Error_Handler();
  }

  sMasterConfig.MasterOutputTrigger = TIM_TRGO_RESET;
  sMasterConfig.MasterSlaveMode = TIM_MASTERSLAVEMODE_DISABLE;
  if (HAL_TIMEx_MasterConfigSynchronization(&htim7, &sMasterConfig) != HAL_OK)
  {
    Error_Handler();
  }

}

/* USART1 init function */
static void MX_USART1_UART_Init(void)
{

  huart1.Instance = USART1;
  huart1.Init.BaudRate = 9600;
  huart1.Init.WordLength = UART_WORDLENGTH_8B;
  huart1.Init.StopBits = UART_STOPBITS_1;
  huart1.Init.Parity = UART_PARITY_NONE;
  huart1.Init.Mode = UART_MODE_TX_RX;
  huart1.Init.HwFlowCtl = UART_HWCONTROL_NONE;
  huart1.Init.OverSampling = UART_OVERSAMPLING_16;
  if (HAL_UART_Init(&huart1) != HAL_OK)
  {
    Error_Handler();
  }

}

/* USART2 init function */
static void MX_USART2_UART_Init(void)
{

  huart2.Instance = USART2;
  huart2.Init.BaudRate = 9600;
  huart2.Init.WordLength = UART_WORDLENGTH_8B;
  huart2.Init.StopBits = UART_STOPBITS_1;
  huart2.Init.Parity = UART_PARITY_NONE;
  huart2.Init.Mode = UART_MODE_TX_RX;
  huart2.Init.HwFlowCtl = UART_HWCONTROL_NONE;
  huart2.Init.OverSampling = UART_OVERSAMPLING_16;
  if (HAL_UART_Init(&huart2) != HAL_OK)
  {
    Error_Handler();
  }

}

/** 
  * Enable DMA controller clock
  */
static void MX_DMA_Init(void) 
{
  /* DMA controller clock enable */
  __HAL_RCC_DMA1_CLK_ENABLE();

  /* DMA interrupt init */
  /* DMA1_Channel2_IRQn interrupt configuration */
  HAL_NVIC_SetPriority(DMA1_Channel2_IRQn, 0, 0);
  HAL_NVIC_EnableIRQ(DMA1_Channel2_IRQn);
  /* DMA1_Channel3_IRQn interrupt configuration */
  HAL_NVIC_SetPriority(DMA1_Channel3_IRQn, 0, 0);
  HAL_NVIC_EnableIRQ(DMA1_Channel3_IRQn);

}

/** Configure pins as 
        * Analog 
        * Input 
        * Output
        * EVENT_OUT
        * EXTI
*/
static void MX_GPIO_Init(void)
{

  GPIO_InitTypeDef GPIO_InitStruct;

  /* GPIO Ports Clock Enable */
  __HAL_RCC_GPIOC_CLK_ENABLE();
  __HAL_RCC_GPIOD_CLK_ENABLE();
  __HAL_RCC_GPIOA_CLK_ENABLE();
  __HAL_RCC_GPIOB_CLK_ENABLE();

  /*Configure GPIO pins : PADS0_Pin PADS1_Pin PADS2_Pin PADS3_Pin */
  GPIO_InitStruct.Pin = PADS0_Pin|PADS1_Pin|PADS2_Pin|PADS3_Pin;
  GPIO_InitStruct.Mode = GPIO_MODE_INPUT;
  GPIO_InitStruct.Pull = GPIO_PULLUP;
  HAL_GPIO_Init(GPIOC, &GPIO_InitStruct);

  /*Configure GPIO pin : FLASH_CS_Pin */
  GPIO_InitStruct.Pin = FLASH_CS_Pin;
  GPIO_InitStruct.Mode = GPIO_MODE_OUTPUT_PP;
  GPIO_InitStruct.Speed = GPIO_SPEED_FREQ_HIGH;
  HAL_GPIO_Init(FLASH_CS_GPIO_Port, &GPIO_InitStruct);

  /*Configure GPIO pins : LEDA_Pin LEDB_Pin RBEEP_Pin LBEEP_Pin */
  GPIO_InitStruct.Pin = LEDA_Pin|LEDB_Pin|RBEEP_Pin|LBEEP_Pin;
  GPIO_InitStruct.Mode = GPIO_MODE_OUTPUT_PP;
  GPIO_InitStruct.Speed = GPIO_SPEED_FREQ_HIGH;
  HAL_GPIO_Init(GPIOC, &GPIO_InitStruct);

  /*Configure GPIO pins : BT_ENB_Pin BT_STATE_Pin LPAD_Pin RPAD_Pin 
                           LCD_BK_Pin */
  GPIO_InitStruct.Pin = BT_ENB_Pin|BT_STATE_Pin|LPAD_Pin|RPAD_Pin 
                          |LCD_BK_Pin;
  GPIO_InitStruct.Mode = GPIO_MODE_OUTPUT_PP;
  GPIO_InitStruct.Speed = GPIO_SPEED_FREQ_LOW;
  HAL_GPIO_Init(GPIOB, &GPIO_InitStruct);

  /*Configure GPIO pins : LCD_CS_Pin LCD_DC_Pin LCD_RST_Pin SCL_Pin */
  GPIO_InitStruct.Pin = LCD_CS_Pin|LCD_DC_Pin|LCD_RST_Pin|SCL_Pin;
  GPIO_InitStruct.Mode = GPIO_MODE_OUTPUT_PP;
  GPIO_InitStruct.Speed = GPIO_SPEED_FREQ_HIGH;
  HAL_GPIO_Init(GPIOB, &GPIO_InitStruct);

  /*Configure GPIO pin : SDST_Pin */
  GPIO_InitStruct.Pin = SDST_Pin;
  GPIO_InitStruct.Mode = GPIO_MODE_INPUT;
  GPIO_InitStruct.Pull = GPIO_PULLUP;
  HAL_GPIO_Init(SDST_GPIO_Port, &GPIO_InitStruct);

  /*Configure GPIO pin : SDA_Pin */
  GPIO_InitStruct.Pin = SDA_Pin;
  GPIO_InitStruct.Mode = GPIO_MODE_OUTPUT_OD;
  GPIO_InitStruct.Speed = GPIO_SPEED_FREQ_HIGH;
  HAL_GPIO_Init(SDA_GPIO_Port, &GPIO_InitStruct);

  /*Configure GPIO pin Output Level */
  HAL_GPIO_WritePin(FLASH_CS_GPIO_Port, FLASH_CS_Pin, GPIO_PIN_SET);

  /*Configure GPIO pin Output Level */
  HAL_GPIO_WritePin(GPIOC, LEDA_Pin|LEDB_Pin|RBEEP_Pin|LBEEP_Pin, GPIO_PIN_RESET);

  /*Configure GPIO pin Output Level */
  HAL_GPIO_WritePin(GPIOB, BT_ENB_Pin|BT_STATE_Pin|LPAD_Pin|RPAD_Pin 
                          |LCD_BK_Pin|LCD_DC_Pin|LCD_RST_Pin|SCL_Pin 
                          |SDA_Pin, GPIO_PIN_RESET);

  /*Configure GPIO pin Output Level */
  HAL_GPIO_WritePin(LCD_CS_GPIO_Port, LCD_CS_Pin, GPIO_PIN_SET);

}

/**
  * @brief  Period elapsed callback in non blocking mode
  * @note   This function is called  when TIM8 interrupt took place, inside
  * HAL_TIM_IRQHandler(). It makes a direct call to HAL_IncTick() to increment
  * a global variable "uwTick" used as application time base.
  * @param  htim : TIM handle
  * @retval None
  */
void HAL_TIM_PeriodElapsedCallback(TIM_HandleTypeDef *htim)
{
  if (htim->Instance == TIM8) {
    HAL_IncTick();
  }
/* USER CODE BEGIN Callback 1 */
	if (htim->Instance == TIM7) {
		//incTime();
	}
	
	if (htim->Instance == TIM6) {
		if (index == 13) {
			if (waitKeyUp(RPAD_RIGHT)) {
				jumpOut();
				index -= 10;
				lcd->clear(lcd->p);
				HAL_TIM_Base_Stop_IT(&htim6);
				HAL_GPIO_WritePin(LBEEP_GPIO_Port, LBEEP_Pin, GPIO_PIN_RESET);
				HAL_GPIO_WritePin(RBEEP_GPIO_Port, RBEEP_Pin, GPIO_PIN_RESET);
			}
		}
		beeperInerrupt();
	}
/* USER CODE END Callback 1 */
}

/**
  * @brief  This function is executed in case of error occurrence.
  * @param  None
  * @retval None
  */
void Error_Handler(void)
{
  /* USER CODE BEGIN Error_Handler */
	  /* User can add his own implementation to report the HAL error return state */
	  while(1) 
	  {
	  }
  /* USER CODE END Error_Handler */ 
}

#ifdef USE_FULL_ASSERT

/**
   * @brief Reports the name of the source file and the source line number
   * where the assert_param error has occurred.
   * @param file: pointer to the source file name
   * @param line: assert_param error line source number
   * @retval None
   */
void assert_failed(uint8_t* file, uint32_t line)
{
  /* USER CODE BEGIN 6 */
	  /* User can add his own implementation to report the file name and line number,
		ex: printf("Wrong parameters value: file %s on line %d\r\n", file, line) */
  /* USER CODE END 6 */

}

#endif

/**
  * @}
  */ 

/**
  * @}
*/ 

/************************ (C) COPYRIGHT STMicroelectronics *****END OF FILE****/
