NSDN/NGP/(commit log)

2016-11-04 add SDIO and USB Mass Storage Device drivers
2016-11-05 okay I forgot to pull up DP pin ((((
2016-11-07 update layout
    [NyaGamePortable-32Bit-v1.1.lay6]
2016-11-07 update layout #2
    [NyaGamePortable-32Bit-v1.1.lay6]
2016-11-11 add sample GUI code and FATFS
2016-11-19 update layout and usb_d
    [NyaGamePortable-32Bit-v1.2.lay6]
2016-11-21 update layout again
    [NyaGamePortable-32Bit-v1.2.lay6]
2016-11-25 add lcd device
2016-11-26 add LCD driver
2016-11-28 update display driver
2016-12-08 add STG sample.
2016-12-17 add power supply port
    [NyaGamePortable-32Bit-v1.2.lay6]
2016-12-17 swap beeper port
    [NyaGamePortable-32Bit-v1.2.lay6]
2016-12-18 add flash driver
2016-12-18 fix flash driver
2016-12-30 try to fix USB
    [NGPMain.ioc, main.c]
2017-01-18 add U.N. Owen was her？
2017-03-31 fix usb and emu keypad
    [main.c]
2017-04-09 modify folder structure
    [NyaGamePortable-32Bit-v1.0.lay6, NyaGamePortable-32Bit-v1.1.lay6, NyaGamePortable-32Bit-v1.2.lay6]
2017-04-10 fix folder structure (1/2)
    [NGPMain.ioc, NGPTest.ioc, NGPUsb.ioc, NGPUsbF4.ioc, OLED.h]
2017-04-10 fix folder structure (2/2) add 8bit files
    [NGPMain.ioc, NGPTest.ioc, NGPUsb.ioc, NGPUsbF4.ioc, OLED.h]
2017-04-10 add layout
    [NyaGamePortable-8Bit-v1.05.lay6, NyaGamePortable-8Bit-v1.1.lay6, NyaGamePortable-8Bit-v1.2.lay6, NyaGamePortable-8Bit.lay6]
2018-05-21 ST7789 and SSD1351 driver ok
    [ngp-core Debug.cfg]
2018-05-22 fix screen driver
2018-06-21 ready for NEW NGP
    [ngp-main.PrjPCB, ngp-main.SchDoc, st-link.PrjPCB, st-link.SchDoc]
2018-06-24 schematic ok
    [ngp-main.PrjPCB, ngp-main.SchDoc, st-link.SchDoc]
2018-07-02 PCB ok
    [ngp-main.PrjPCB, ngp-main.SchDoc]
2018-07-02 board ok
    [logo.PcbLib]
2018-10-19 NGPv2 ok
    [ngp-main Run.cfg]
2018-10-19 keypad ok
    [ngp-main Run.cfg]
