NSDN/NGP/(notices)

Notices in the files:
firmware/ngp-main/Inc/ffconf.h:
Copyright (c) 2019 STMicroelectronics International N.V.
All rights reserved.
